Akshajk3/6502-Computer/production/bom.csv

Designator | Footprint | Quantity | Value | LCSC Part #
C1 | C_Disc_D5.0mm_W2.5mm_P5.00mm | 1 | 1u
J1 | PinHeader_1x16_P2.54mm_Vertical | 1 | Conn_01x16_Pin
J2 | PinHeader_1x08_P2.54mm_Vertical | 1 | Conn_01x08_Pin
J3 | PinHeader_1x03_P2.54mm_Vertical | 1 | Conn_01x03_Pin
J4 | PinHeader_1x02_P2.54mm_Vertical | 1 | Conn_01x02_Pin
J5 | PinHeader_1x05_P2.54mm_Vertical | 1 | Conn_01x05_Pin
R1 | R_Axial_DIN0207_L6.3mm_D2.5mm_P10.16mm_Horizontal | 1 | 10k
R2, R3, R4 | R_Axial_DIN0207_L6.3mm_D2.5mm_P10.16mm_Horizontal | 3 | 3.3k
SW1 | SW_PUSH_6mm_H5mm | 1 | SW_Push
U1 | DIP-40_W15.24mm_Socket | 1 | W65C816SxP
