Akshajk3/6502-Computer/EEPROM_Programmer/production/bom.csv

Designator | Footprint | Quantity | Value | LCSC Part #
J1 | PinSocket_1x08_P2.54mm_Vertical | 1 | Power
J2 | PinSocket_1x10_P2.54mm_Vertical | 1 | PWM
J3, J5 | PinSocket_1x08_P2.54mm_Vertical | 2 | Analog
J4 | PinSocket_1x08_P2.54mm_Vertical | 1 | PWM
J6 | PinSocket_1x08_P2.54mm_Vertical | 1 | Communication
J7 | PinSocket_2x18_P2.54mm_Vertical | 1 | Digital
U1 | DIP-28_W15.24mm_Socket | 1 | 28C256
