Akshajk3/6502-Computer/EEPROM_Programmer/EEPROM_Programmer.kicad_pcb

## KiCad design EEPROM_Programmer/EEPROM_Programmer.kicad_pcb (2026-10-19)

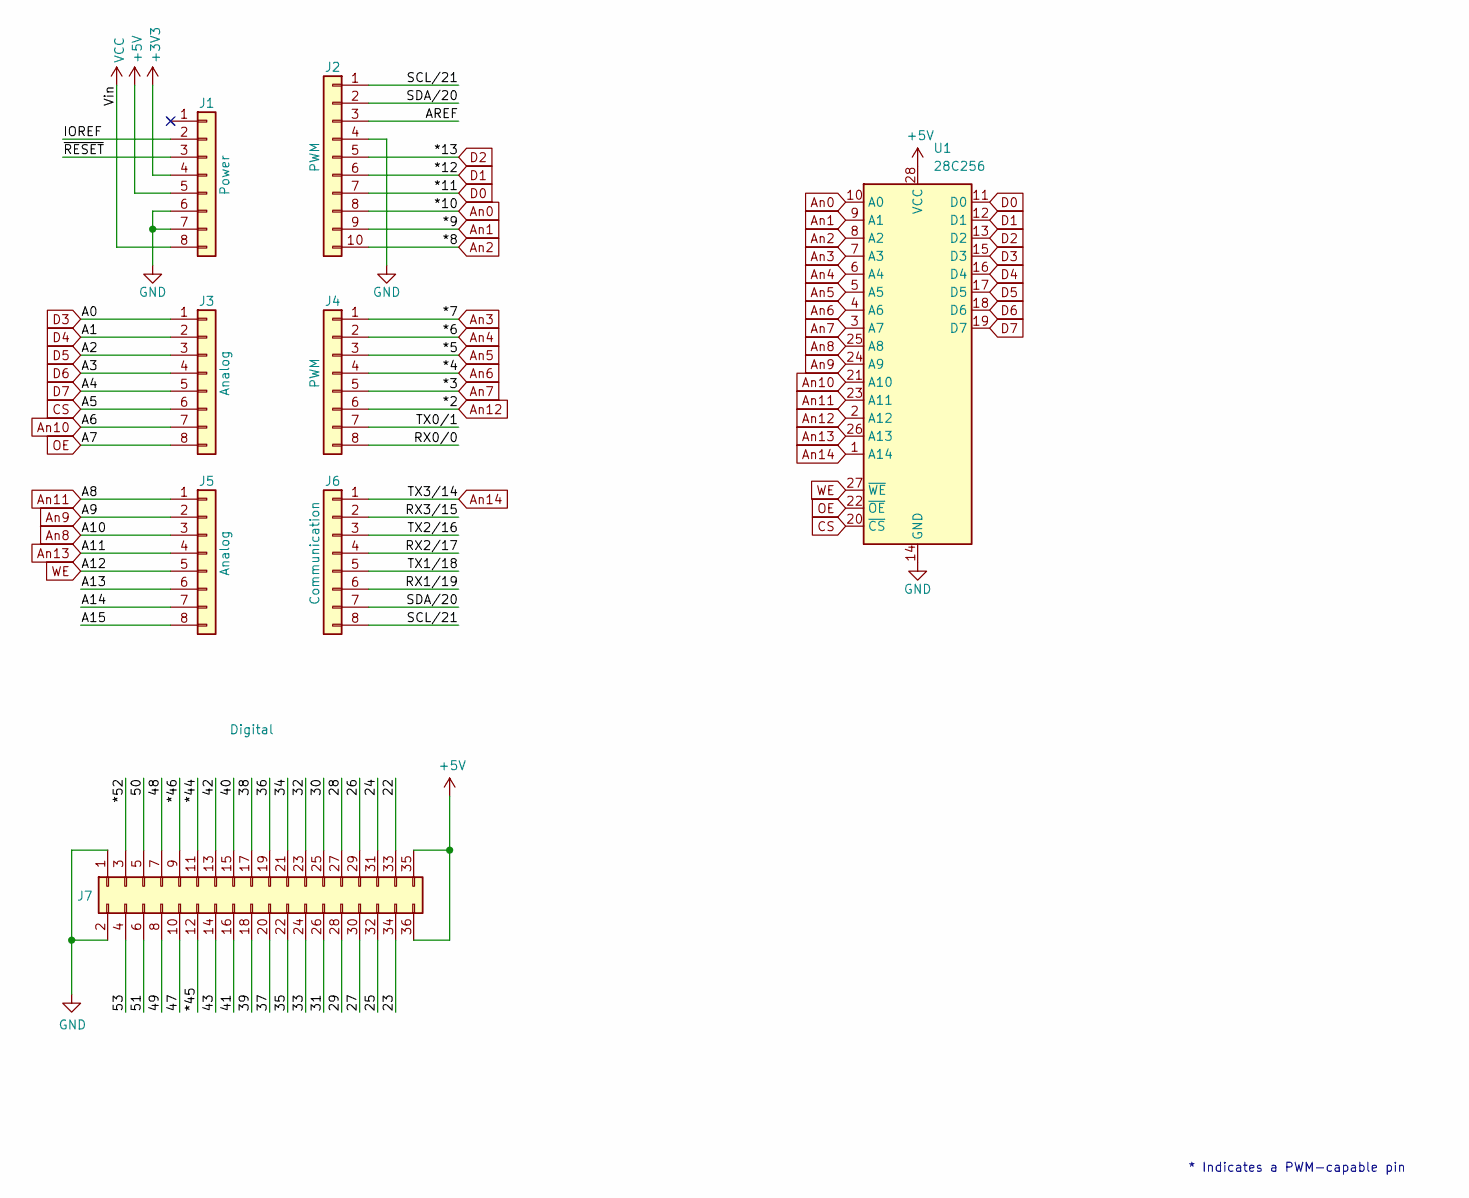
[picture p1: schematic EEPROM_Programmer.kicad_sch]

Parts:
J1: Power; PinHeader_1x08_P2.54mm_Vertical
J2: PWM; PinHeader_1x10_P2.54mm_Vertical
J3, J5: Analog; PinHeader_1x08_P2.54mm_Vertical
J4: PWM; PinHeader_1x08_P2.54mm_Vertical
J6: Communication; PinHeader_1x08_P2.54mm_Vertical
J7: Digital; PinHeader_2x18_P2.54mm_Vertical
U1: 28C256; DIP-28_W15.24mm_Socket

Connections:
+3V3: J1.4
+5V: J1.5, J7.35, J7.36, U1.28 (VCC)
/22: J7.33
/23: J7.34
/24: J7.31
/25: J7.32
/26: J7.29
/27: J7.30
/28: J7.27
/29: J7.28
/30: J7.25
/31: J7.26
/32: J7.23
/33: J7.24
/34: J7.21
/35: J7.22
/36: J7.19
/37: J7.20
/38: J7.17
/39: J7.18
/40: J7.15
/41: J7.16
/42: J7.13
/43: J7.14
/47: J7.10
/48: J7.7
/49: J7.8
/50: J7.5
/51: J7.6
/53: J7.4
/*44: J7.11
/*45: J7.12
/*46: J7.9
/*52: J7.3
/A13: J5.6
/A14: J5.7
/A15: J5.8
/AREF: J2.3
/IOREF: J1.2
/RX0/0: J4.8
/RX1/19: J6.6
/RX2/17: J6.4
/RX3/15: J6.2
/SCL/21: J2.1, J6.8
/SDA/20: J2.2, J6.7
/TX0/1: J4.7
/TX1/18: J6.5
/TX2/16: J6.3
/~RESET: J1.3
An0: J2.8, U1.10 (A0)
An1: J2.9, U1.9 (A1)
An2: J2.10, U1.8 (A2)
An3: J4.1, U1.7 (A3)
An4: J4.2, U1.6 (A4)
An5: J4.3, U1.5 (A5)
An6: J4.4, U1.4 (A6)
An7: J4.5, U1.3 (A7)
An8: J5.3, U1.25 (A8)
An9: J5.2, U1.24 (A9)
An10: J3.7, U1.21 (A10)
An11: J5.1, U1.23 (A11)
An12: J4.6, U1.2 (A12)
An13: J5.4, U1.26 (A13)
An14: J6.1, U1.1 (A14)
CS: J3.6, U1.20 (~CS)
D0: J2.7, U1.11 (D0)
D1: J2.6, U1.12 (D1)
D2: J2.5, U1.13 (D2)
D3: J3.1, U1.15 (D3)
D4: J3.2, U1.16 (D4)
D5: J3.3, U1.17 (D5)
D6: J3.4, U1.18 (D6)
D7: J3.5, U1.19 (D7)
GND: J1.6, J1.7, J2.4, J7.1, J7.2, U1.14 (GND)
OE: J3.8, U1.22 (~OE)
VCC: J1.8
WE: J5.5, U1.27 (~WE)

Notes on the sheet:
* Indicates a PWM-capable pin

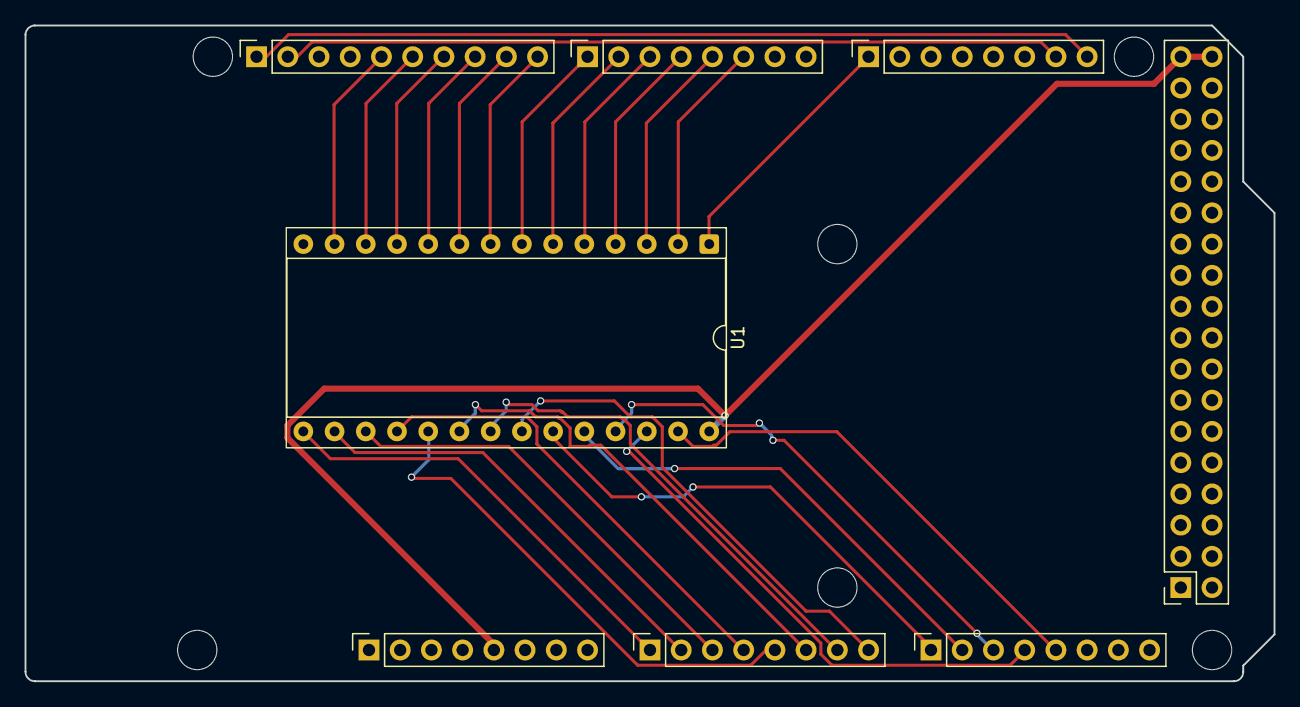
[picture p2: board EEPROM_Programmer.kicad_pcb from above]

Board: 2 copper layers, 101.6 x 53.3 mm, 14 parts (0 on the bottom side), 30 nets.

Other parts of the board:
MH1, MH2, MH3, MH4, MH5, MH6: MountingHole_3.2mm
