Akshajk3/6502-Computer/6502 Computer.kicad_pcb

## KiCad design 6502 Computer.kicad_pcb (2026-10-16)

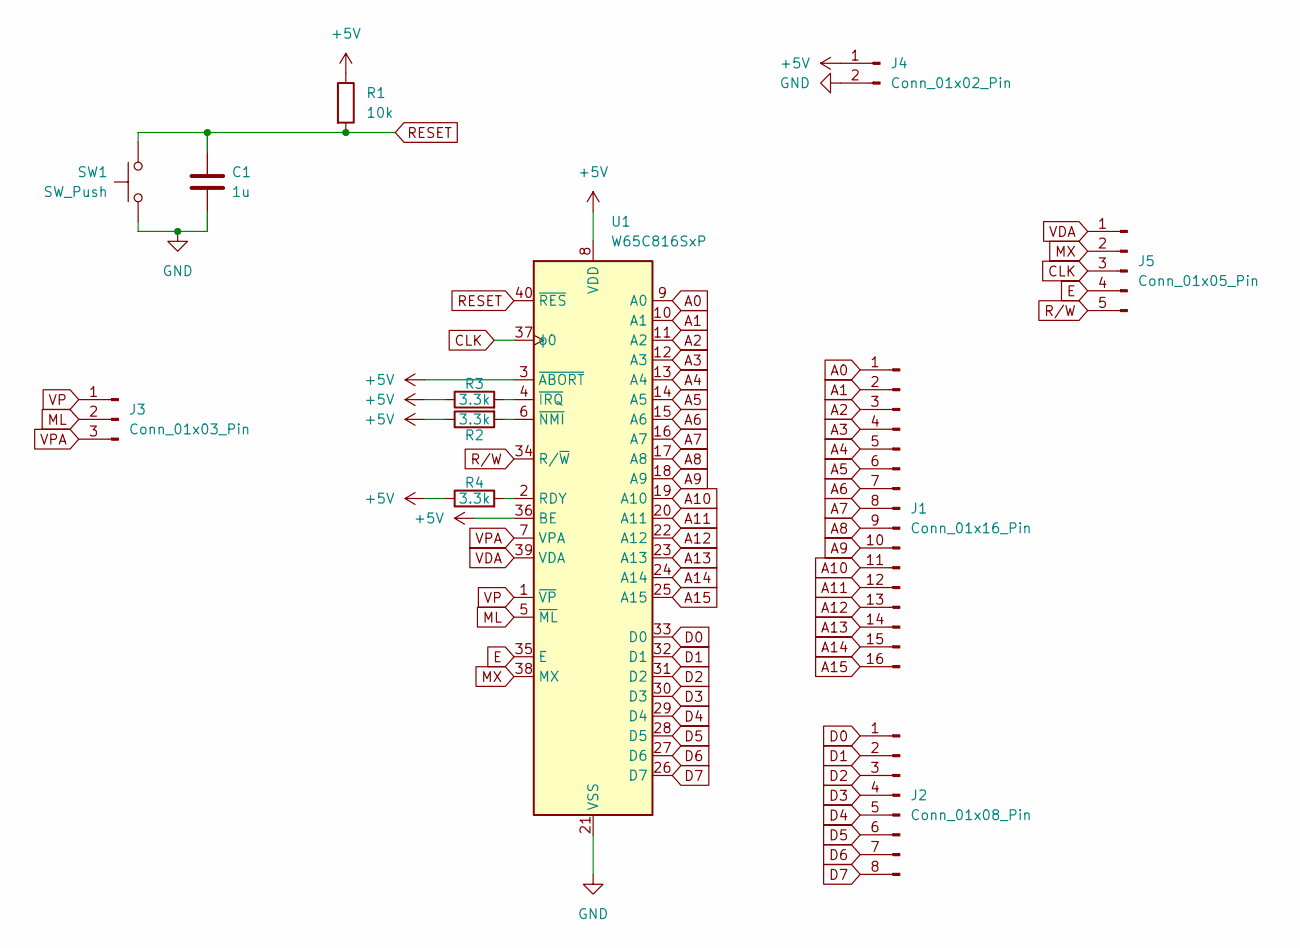
[picture p3: schematic 6502 Computer.kicad_sch]

Parts:
C1: 1u; C_Disc_D5.0mm_W2.5mm_P5.00mm
J1: Conn_01x16_Pin; PinHeader_1x16_P2.54mm_Vertical
J2: Conn_01x08_Pin; PinHeader_1x08_P2.54mm_Vertical
J3: Conn_01x03_Pin; PinHeader_1x03_P2.54mm_Vertical
J4: Conn_01x02_Pin; PinHeader_1x02_P2.54mm_Vertical
J5: Conn_01x05_Pin; PinHeader_1x05_P2.54mm_Vertical
R1: 10k; R_Axial_DIN0207_L6.3mm_D2.5mm_P10.16mm_Horizontal
R2, R3, R4: 3.3k; R_Axial_DIN0207_L6.3mm_D2.5mm_P10.16mm_Horizontal
SW1: SW_Push; SW_PUSH_6mm_H5mm
U1: W65C816SxP; DIP-40_W15.24mm_Socket

Connections:
+5V: J4.1, R1.1, R2.1, R3.1, R4.1, U1.3 (~ABORT), U1.8 (VDD), U1.36 (BE)
A0: J1.1, U1.9 (A0)
A1: J1.2, U1.10 (A1)
A2: J1.3, U1.11 (A2)
A3: J1.4, U1.12 (A3)
A4: J1.5, U1.13 (A4)
A5: J1.6, U1.14 (A5)
A6: J1.7, U1.15 (A6)
A7: J1.8, U1.16 (A7)
A8: J1.9, U1.17 (A8)
A9: J1.10, U1.18 (A9)
A10: J1.11, U1.19 (A10)
A11: J1.12, U1.20 (A11)
A12: J1.13, U1.22 (A12)
A13: J1.14, U1.23 (A13)
A14: J1.15, U1.24 (A14)
A15: J1.16, U1.25 (A15)
CLK: J5.3, U1.37 (ϕ0)
D0: J2.1, U1.33 (D0)
D1: J2.2, U1.32 (D1)
D2: J2.3, U1.31 (D2)
D3: J2.4, U1.30 (D3)
D4: J2.5, U1.29 (D4)
D5: J2.6, U1.28 (D5)
D6: J2.7, U1.27 (D6)
D7: J2.8, U1.26 (D7)
E: J5.4, U1.35 (E)
GND: C1.2, J4.2, SW1.2, U1.21 (VSS)
ML: J3.2, U1.5 (~ML)
MX: J5.2, U1.38 (MX)
unnamed: R4.2, U1.2 (RDY)
unnamed: R3.2, U1.4 (~IRQ)
unnamed: R2.2, U1.6 (~NMI)
RESET: C1.1, R1.2, SW1.1, U1.40 (~RES)
R/W: J5.5, U1.34 (R/~W)
VDA: J5.1, U1.39 (VDA)
VP: J3.1, U1.1 (~VP)
VPA: J3.3, U1.7 (VPA)

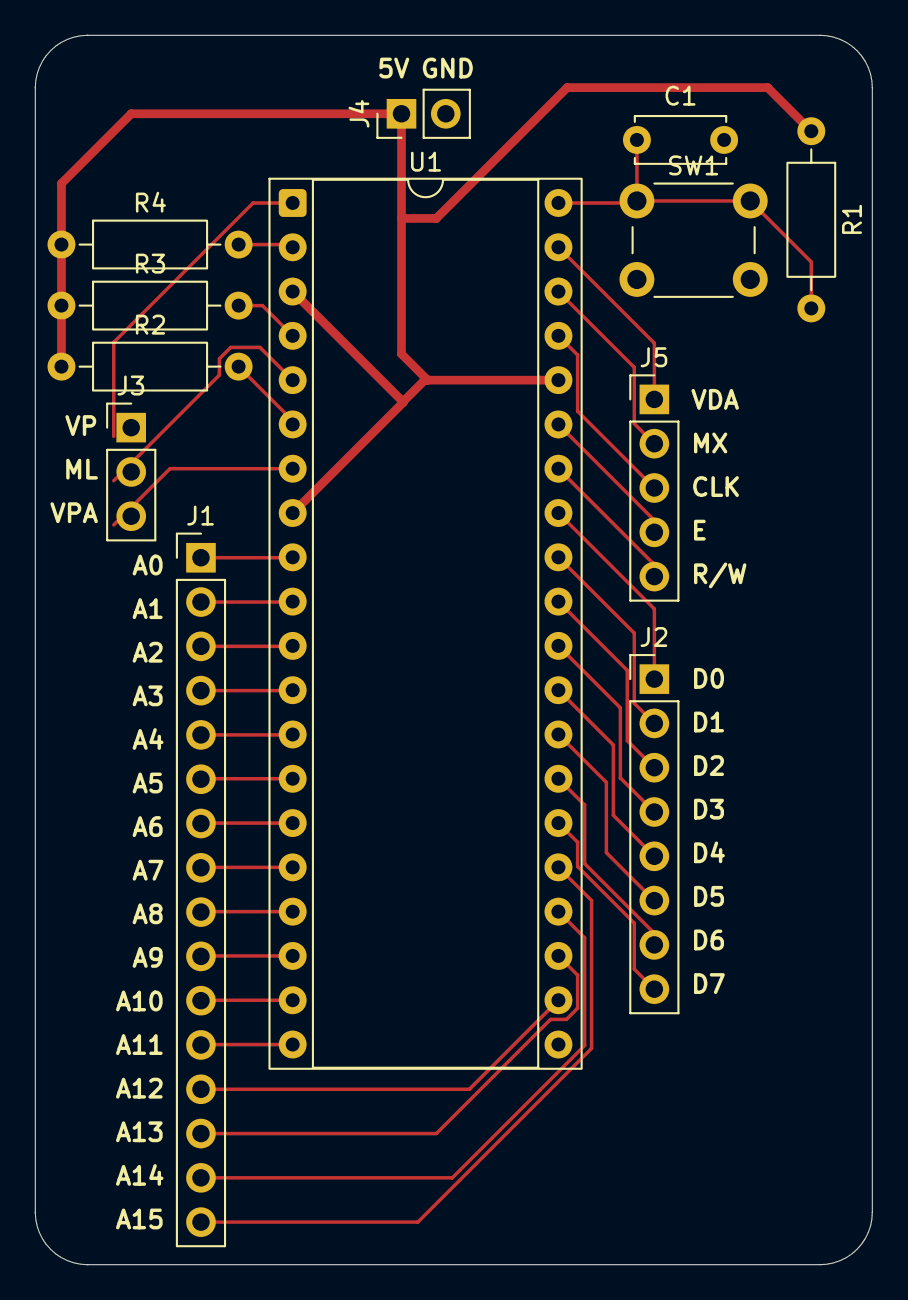
[picture p4: board 6502 Computer.kicad_pcb from above]

Board: 2 copper layers, 48.0 x 70.5 mm, 12 parts (0 on the bottom side), 38 nets.
