Akshajk3/6502-Computer/(commit log)

2025-02-24 fixed issue with schematics where the wrong CPU was used <:(
2025-05-11 allowed the file uploader to emulate funcitonality of the serial montior, need to reimplement code with a raspberry pi because arduino uno doesnt have enought GPIO pins
2025-05-12 rewrote EEPROM programmer to work with raspberry pi, giving address to full 32k and full addressable range rather than just the 128b with the arduino uno
2025-05-12 wrote a simple assembly program to blink some LED havent tested yet
2025-05-13 wrote some test assembly code
2025-05-14 got the file uploader working, and wrote a script to generate a writable ROM file from a assembled bin file
2025-06-28 started reworking the EERPOM programmer for arduino mega
2026-10-16 Finished creating debug board and sent for manufacturing
